evanking12/FreeRTOS_RISCV32I/FPGA_CPU1.srcs/sources_1/new/VICTORY_BACKUP_FreeRTOS_Working_Dec5/firmware/freertos_port/port.c

/*
 * FreeRTOS RISC-V Port - srv32 Style (Proven Working)
 * Simple approach: C handlers, no ISR stack complexity
 */

#include "FreeRTOS.h"
#include "task.h"
#include <stdint.h>
#include "../uart.h"

/* External assembly functions */
extern void xPortStartFirstTask(void);

/* Critical nesting counter (referenced in portmacro.h) */
size_t xCriticalNesting = 0;

/* Machine CSRs */
#define read_csr(reg) ({ uint32_t v; __asm volatile ("csrr %0, " #reg : "=r"(v)); v; })
#define write_csr(reg, val) __asm volatile ("csrw " #reg ", %0" :: "rK"(val))

/* Memory-mapped timer registers */
#define MTIME_LO     (*(volatile uint32_t *)(configMTIME_BASE_ADDRESS))
#define MTIME_HI     (*(volatile uint32_t *)(configMTIME_BASE_ADDRESS + 4))
#define MTIMECMP_LO  (*(volatile uint32_t *)(configMTIMECMP_BASE_ADDRESS))
#define MTIMECMP_HI  (*(volatile uint32_t *)(configMTIMECMP_BASE_ADDRESS + 4))

/*-----------------------------------------------------------*/

/* Helper to read 64-bit mtime safely */
static inline uint64_t read_mtime(void) {
    uint32_t lo, hi;
    do {
        hi = MTIME_HI;
        lo = MTIME_LO;
    } while (hi != MTIME_HI);
    return ((uint64_t)hi << 32) | lo;
}

/* Helper to write 64-bit mtimecmp safely */
static inline void write_mtimecmp(uint64_t val) {
    MTIMECMP_HI = 0xFFFFFFFF;       /* Prevent spurious interrupt */
    MTIMECMP_LO = (uint32_t)val;
    MTIMECMP_HI = (uint32_t)(val >> 32);
}

/*-----------------------------------------------------------*/

void vPortSetupTimerInterrupt(void)
{
    uint64_t now = read_mtime();
    uint64_t next = now + (configCPU_CLOCK_HZ / configTICK_RATE_HZ);
    write_mtimecmp(next);
}

/*-----------------------------------------------------------*/

BaseType_t xPortStartScheduler(void)
{
    /* Disable all interrupts during setup */
    write_csr(mstatus, 0);
    write_csr(mie, 0);
    
    /* Setup timer for tick interrupt */
    vPortSetupTimerInterrupt();
    
    /* Enable timer interrupt (bit 7 = MTIE) */
    write_csr(mie, (1 << 7));
    
    /* Start first task - sets mtvec, enables interrupts via mret */
    xPortStartFirstTask();

    /* Should never get here */
    return pdFALSE;
}

/*-----------------------------------------------------------*/

void vPortEndScheduler(void)
{
    for (;;);
}

/*-----------------------------------------------------------*/

/* Timer interrupt handler - called from assembly trap handler */
void vPortSysTickHandler(void)
{
    /* Update timer compare for next tick FIRST (clears interrupt) */
    uint64_t cmp = ((uint64_t)MTIMECMP_HI << 32) | MTIMECMP_LO;
    uint64_t next = cmp + (configCPU_CLOCK_HZ / configTICK_RATE_HZ);
    write_mtimecmp(next);

    /* Run FreeRTOS tick processing */
    if (xTaskIncrementTick() != pdFALSE) {
        vTaskSwitchContext();
    }
}

/*-----------------------------------------------------------*/

/* Yield handler - called from assembly trap handler on ecall */
void vPortYieldHandler(void)
{
    vTaskSwitchContext();
}

/*-----------------------------------------------------------*/

/* FreeRTOS hooks */
void vApplicationIdleHook(void)
{
    /* Idle - do nothing */
}

void vApplicationTickHook(void)
{
    /* Called every tick - can add custom tick processing here */
}

void vApplicationMallocFailedHook(void)
{
    uart_puts("[PORT] MALLOC FAILED!\r\n");
    for (;;);
}

void vApplicationStackOverflowHook(TaskHandle_t xTask, char *pcTaskName)
{
    (void)xTask;
    uart_puts("[PORT] STACK OVERFLOW: ");
    uart_puts(pcTaskName);
    uart_puts("\r\n");
    for (;;);
}
