evanking12/FreeRTOS_RISCV32I/FPGA_CPU1.srcs/sources_1/new/VICTORY_BACKUP_FreeRTOS_Working_Dec5/firmware/mem_util.c

#include <stddef.h>

void *memcpy( void *dst, const void *src, size_t n )
{
    unsigned char *d = (unsigned char *)dst;
    const unsigned char *s = (const unsigned char *)src;
    for( size_t i = 0; i < n; i++ )
    {
        d[i] = s[i];
    }
    return dst;
}

void *memset( void *dst, int c, size_t n )
{
    unsigned char *d = (unsigned char *)dst;
    unsigned char val = (unsigned char)c;
    for( size_t i = 0; i < n; i++ )
    {
        d[i] = val;
    }
    return dst;
}
